davidzindovic/EEG-Lotus/README.md

Project for my Bachelors final work - Mechanical Flower controlled by EEG, for promotional purposes.

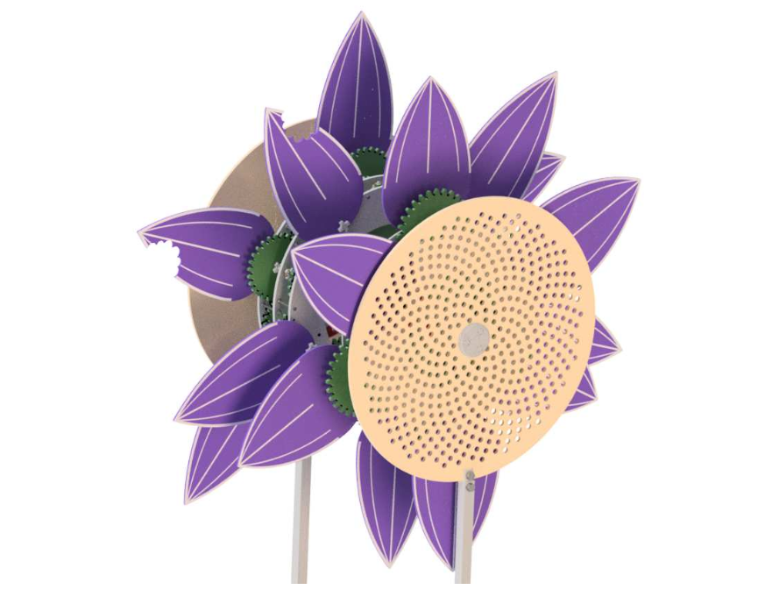
[picture p1: roza.png]
EEG Lotus
