davidzindovic/EEG-Lotus/(commit log)

2024-01-08 Create stepper test
2024-02-22 Update stepper test
2024-02-24 Create EEG regulacija in motor
2024-02-24 Update EEG regulacija in motor
2024-04-03 Create stepper s tipkama
2024-04-03 Update stepper s tipkama
2024-05-17 Create Arduino serial logger test
2024-05-25 Update Arduino serial logger test
2024-06-10 Create timer lib test.ino
